AlessandroJGomes/Word-Clock/Word-Clock2/Presentazione/WordClock.pptx

## Word-Clock

Alessandro gomes e Fabio gola

## Indice

- Analisi
- Progettazione
- Implementazione
- Test
- Conclusione

## Slide 3

Analisi

## Analisi – richiesta del mandante

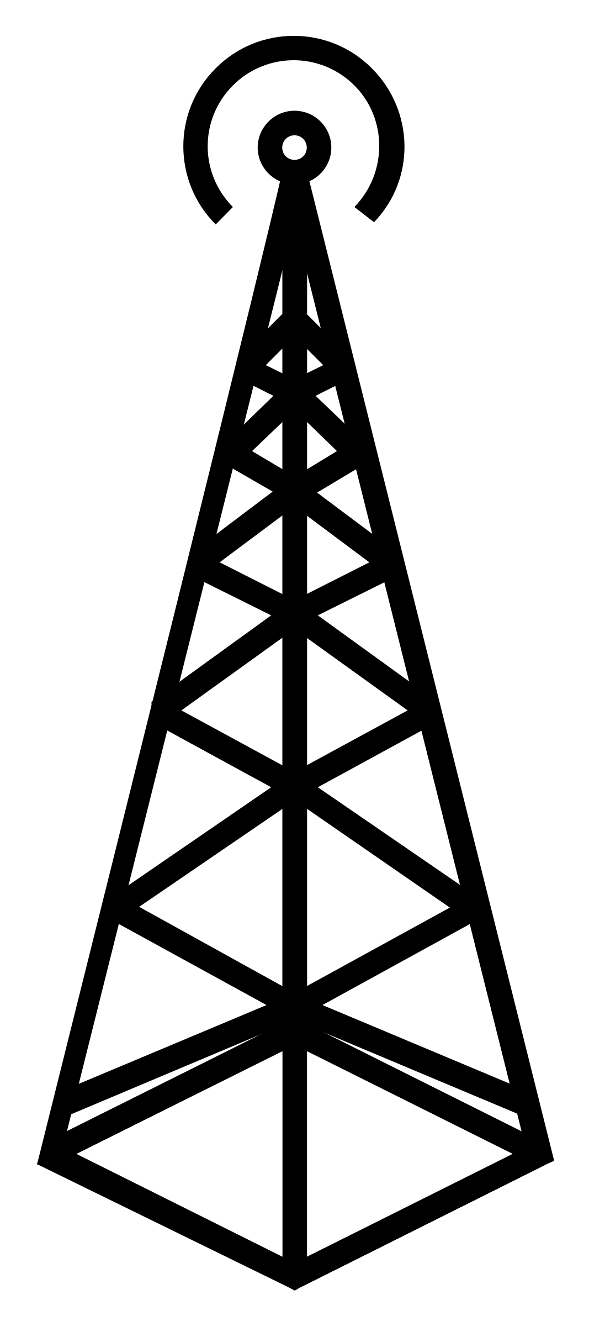
[picture p58: figure]
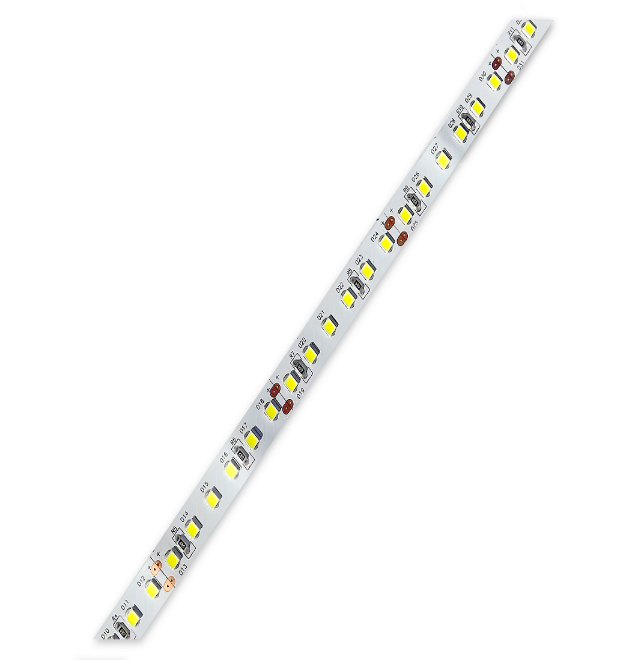
[picture p59: figure]
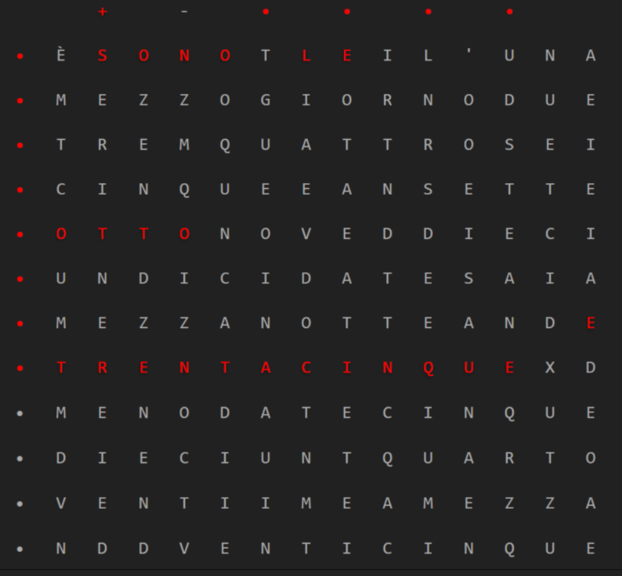
[picture p60: figure]
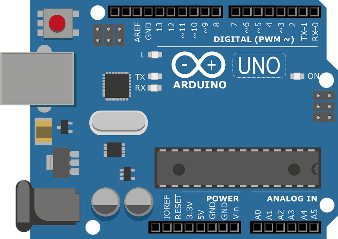
[picture p61: figure]
Risultati immagini per arduino
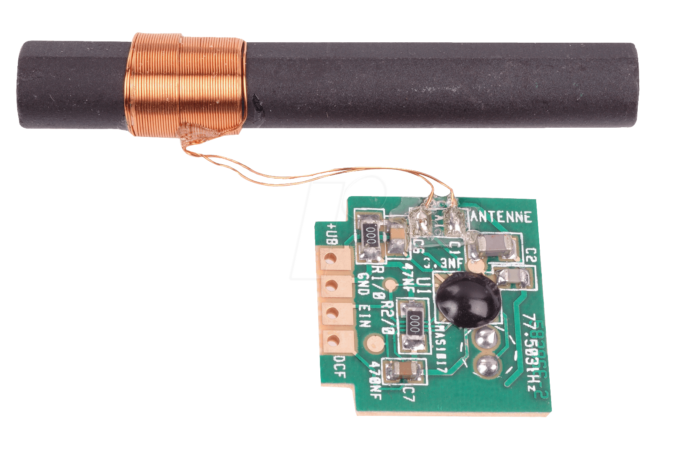
[picture p62: figure]

## Analisi – costi

## Slide 6

Progettazione

## Progettazione

Sincronizzazione orario
Gestione illuminazione
Controllo on board

Arduino

Arduino

Arduino

## Progettazione – controllo on board


## Slide 9

Implementazione

## Implementazione elettrovalvola

## Implementazione infrarossi

## Slide 12

Test

## Test

## Test

## Slide 15

Conclusioni

## Conclusioni

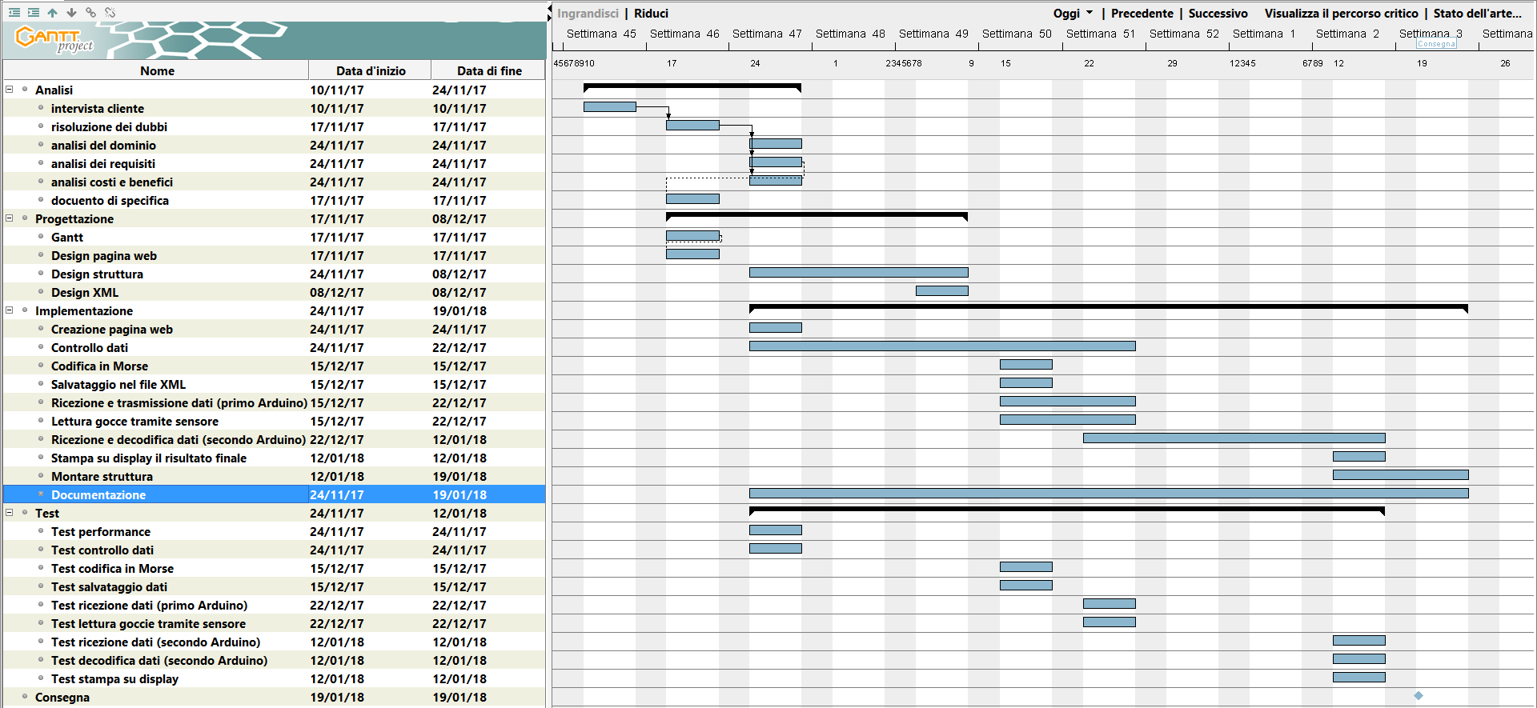
[picture p63: figure]

## Conclusioni

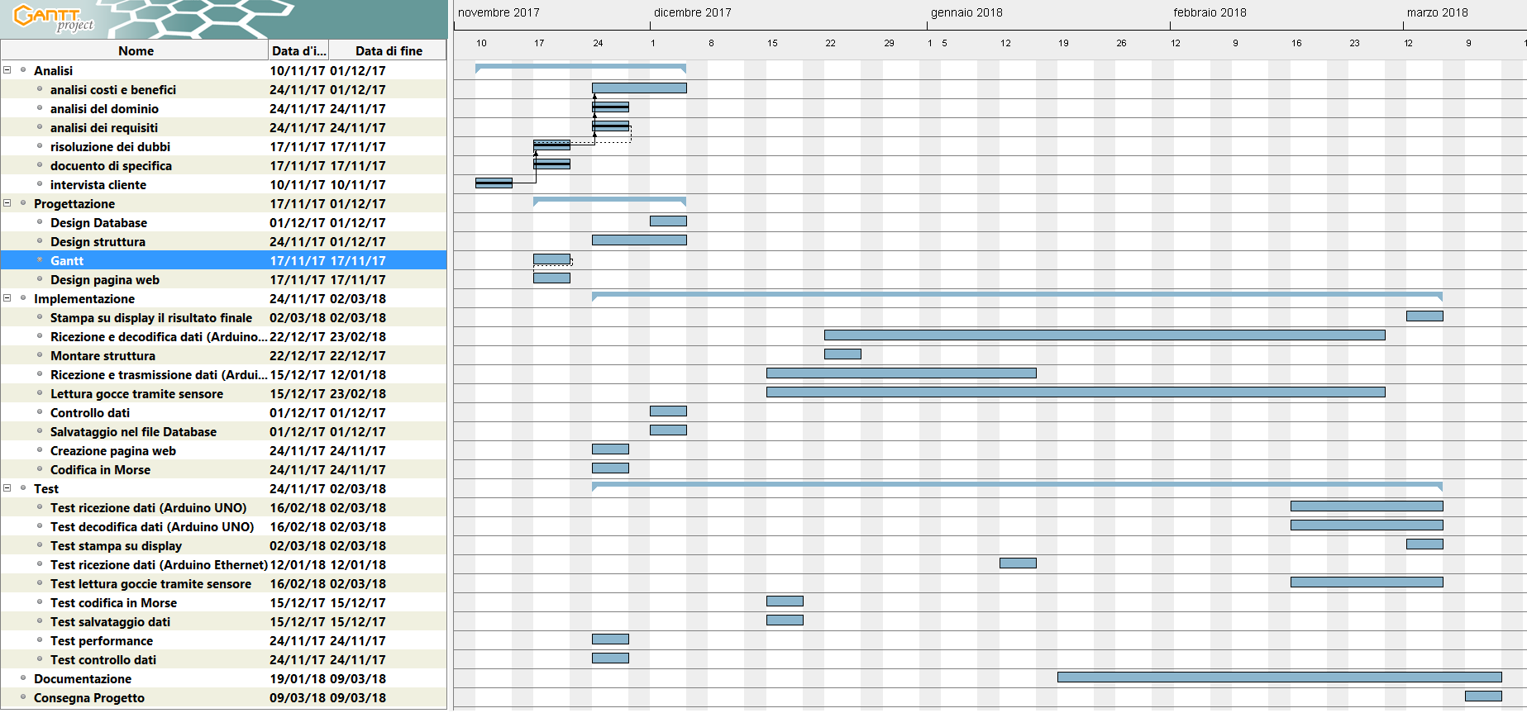
[picture p64: figure]

## Sviluppi futuri

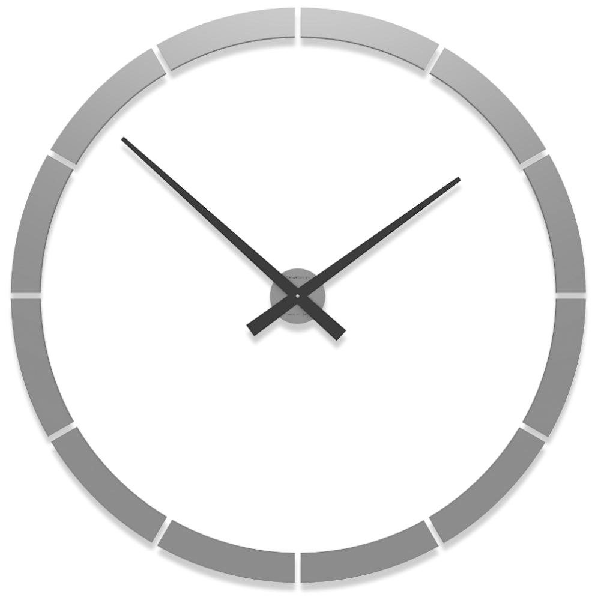
[picture p65: figure]
Risultati immagini per orologio

## Slide 19

Domande ?
