AlessandroJGomes/Word-Clock/Word-Clock2.1/doc/Allegati/20170317_102902.jpg

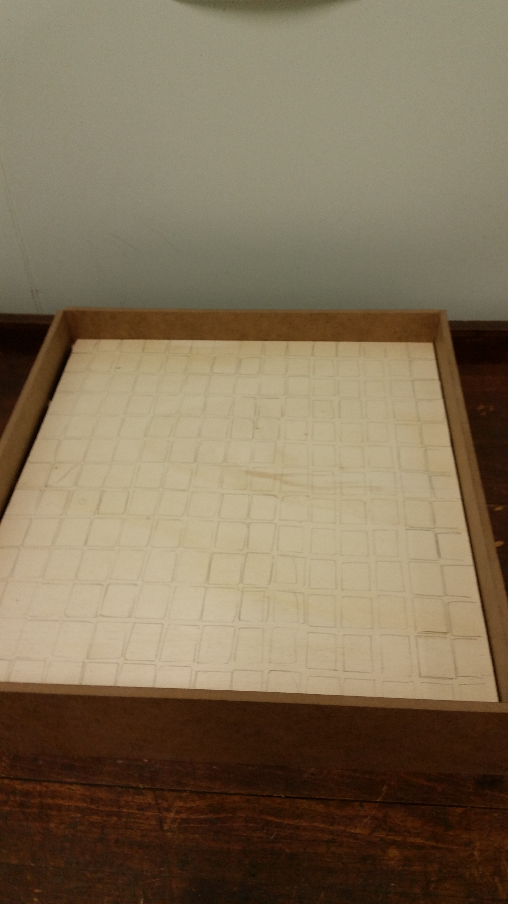
Word-Clock2.1/doc/Allegati/20170317_102902.jpg
