AlessandroJGomes/Word-Clock/Word-Clock2.1/doc/Allegati/20170505_132712.jpg

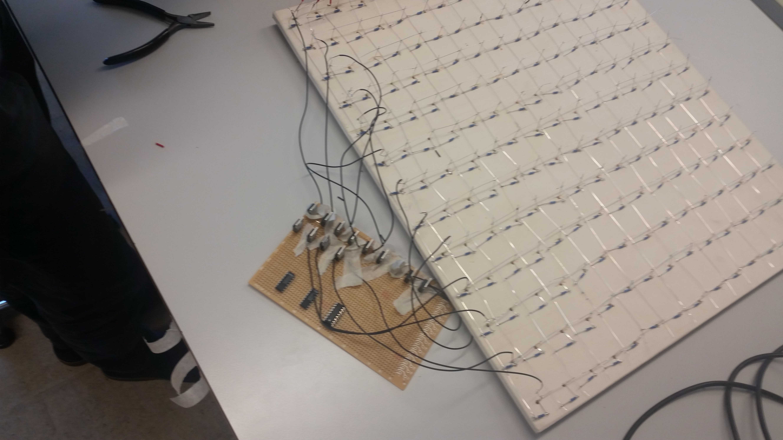
Word-Clock2.1/doc/Allegati/20170505_132712.jpg
