AlessandroJGomes/Word-Clock/Word-Clock2.1/doc/Allegati/De.PNG

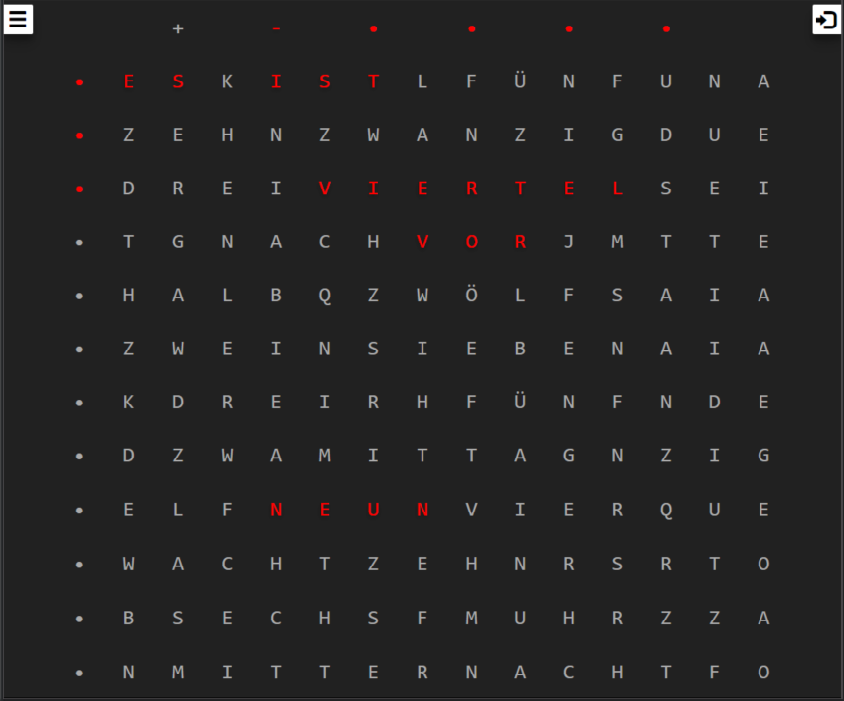
Word-Clock2.1/doc/Allegati/De.PNG
