AlessandroJGomes/Word-Clock/Word-Clock2.1/doc/Allegati/Fr.PNG

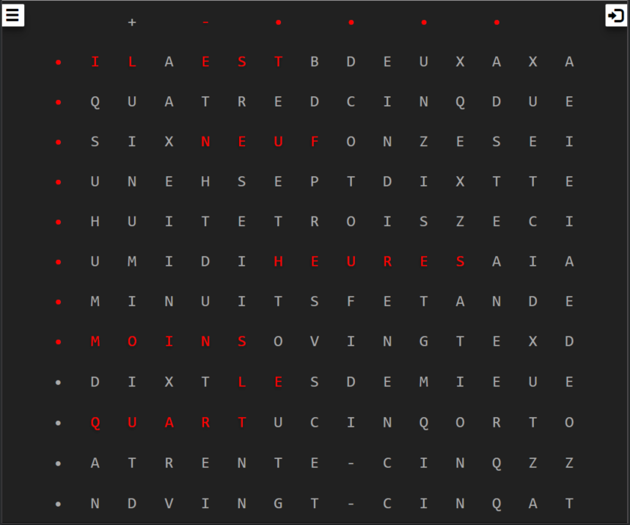
Word-Clock2.1/doc/Allegati/Fr.PNG
