AlessandroJGomes/Word-Clock/Word-Clock2.1/doc/Allegati/Griglia.png

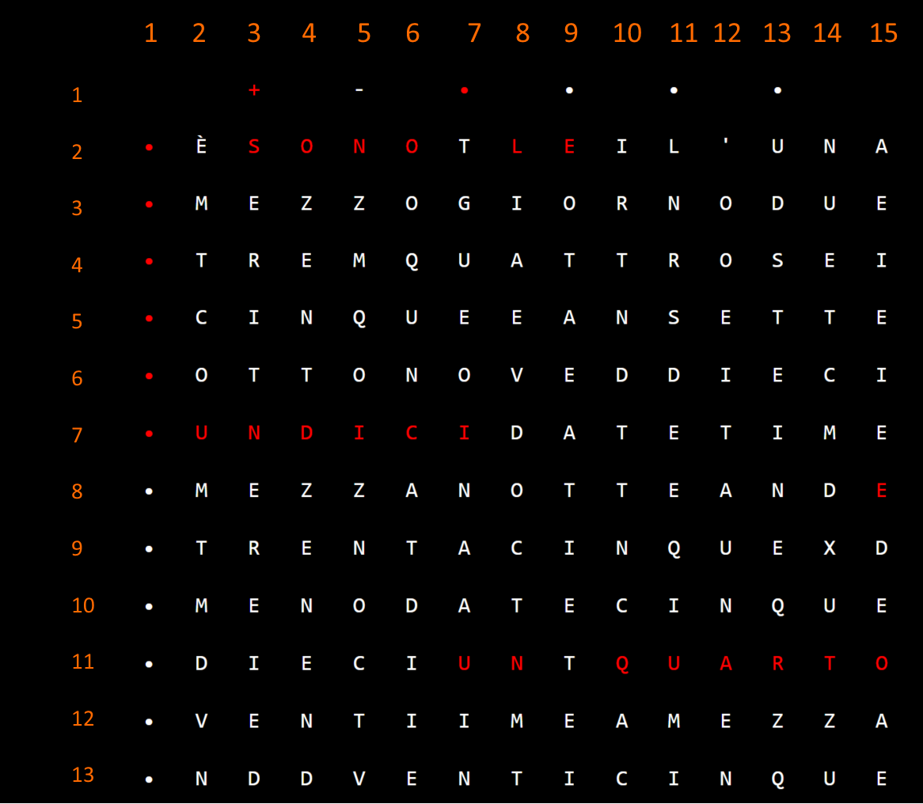
Word-Clock2.1/doc/Allegati/Griglia.png
