AlessandroJGomes/Word-Clock/Word-Clock2.1/doc/Allegati/veroboard.jpg

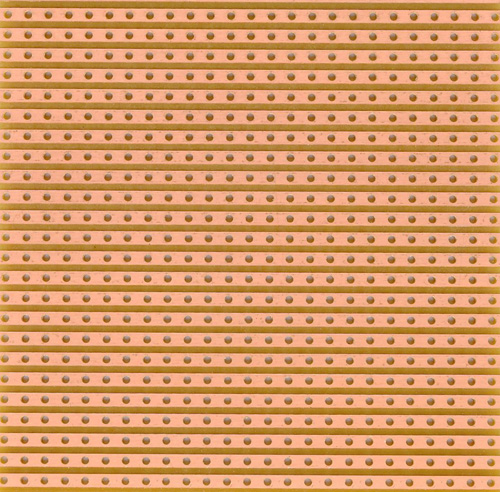
Word-Clock2.1/doc/Allegati/veroboard.jpg
