AlessandroJGomes/Word-Clock/Word-Clock2/Presentazione/accensioneSimboli.PNG

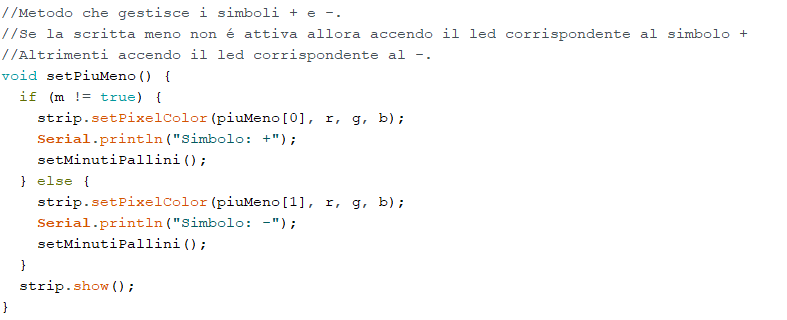
Word-Clock2/Presentazione/accensioneSimboli.PNG
