AlessandroJGomes/Word-Clock/Word-Clock2/Presentazione/arrayParoleSpeciali.PNG

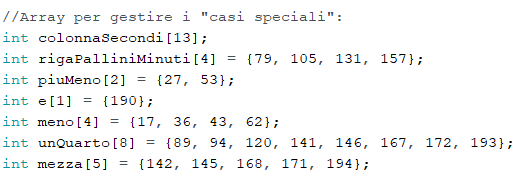
Word-Clock2/Presentazione/arrayParoleSpeciali.PNG
