AlessandroJGomes/Word-Clock/Word-Clock2/Presentazione/costo personale.PNG

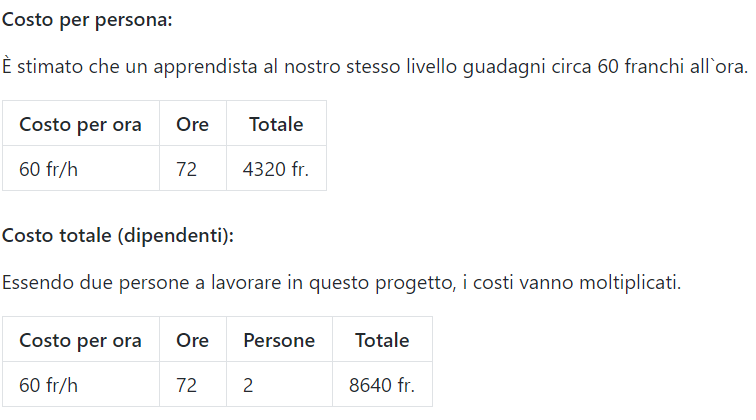
Word-Clock2/Presentazione/costo personale.PNG
