AlessandroJGomes/Word-Clock/Word-Clock2/Presentazione/costomateriale.PNG

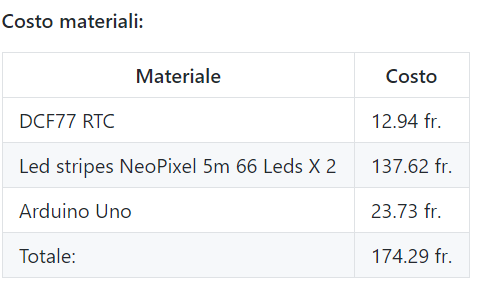
Word-Clock2/Presentazione/costomateriale.PNG
