AlessandroJGomes/Word-Clock/Word-Clock2/Presentazione/costotot.PNG

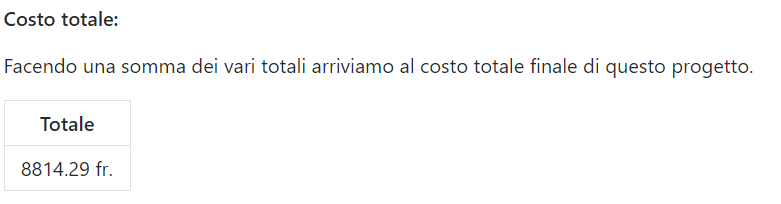
Word-Clock2/Presentazione/costotot.PNG
