AlessandroJGomes/Word-Clock/Word-Clock2/Presentazione/df77prova1.PNG

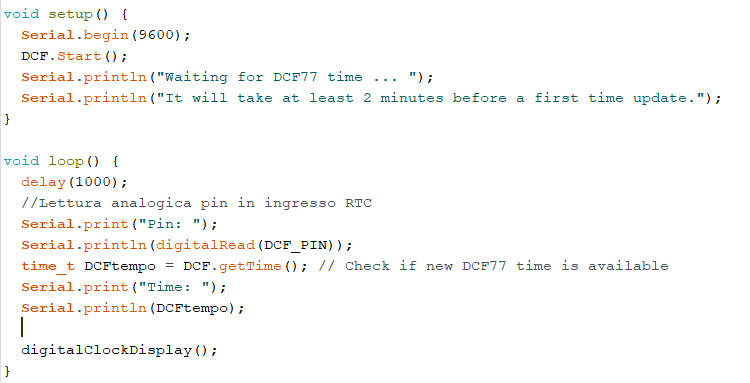
Word-Clock2/Presentazione/df77prova1.PNG
