AlessandroJGomes/Word-Clock/Word-Clock2/Presentazione/GanttConsuntivo.PNG

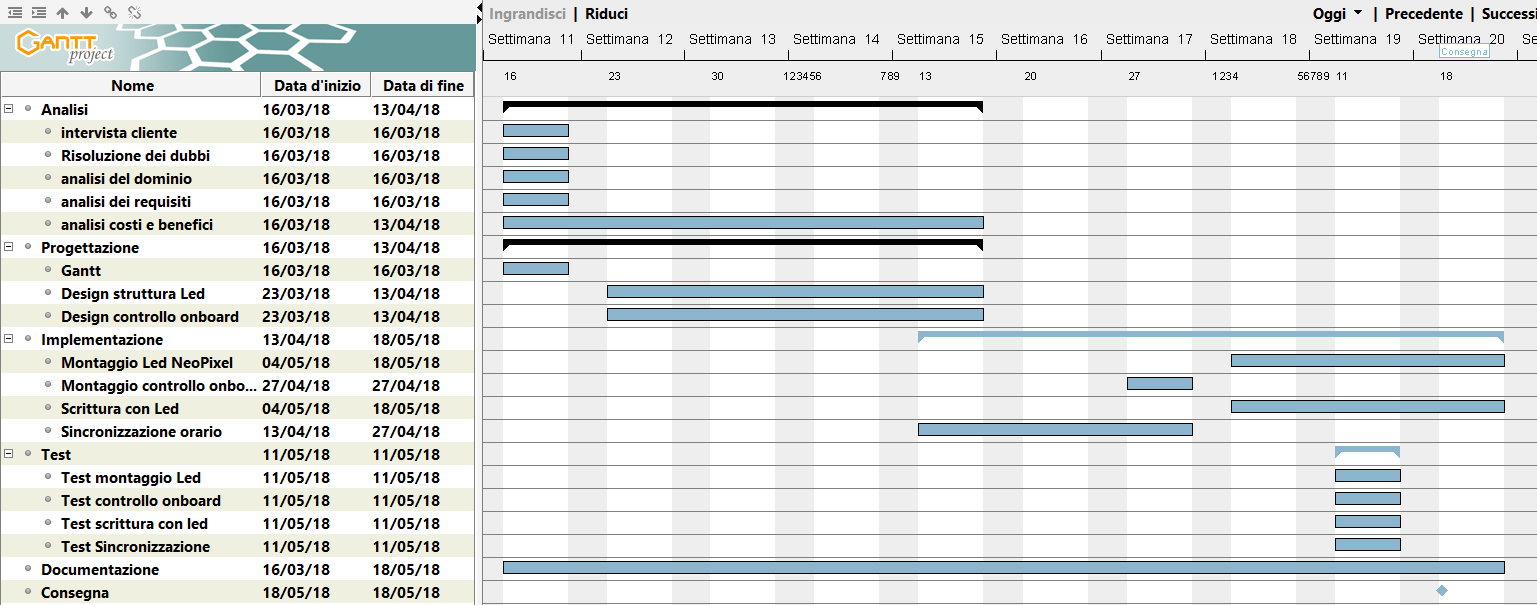
Word-Clock2/Presentazione/GanttConsuntivo.PNG
