AlessandroJGomes/Word-Clock/Word-Clock2/Presentazione/GanttPreventivo.PNG

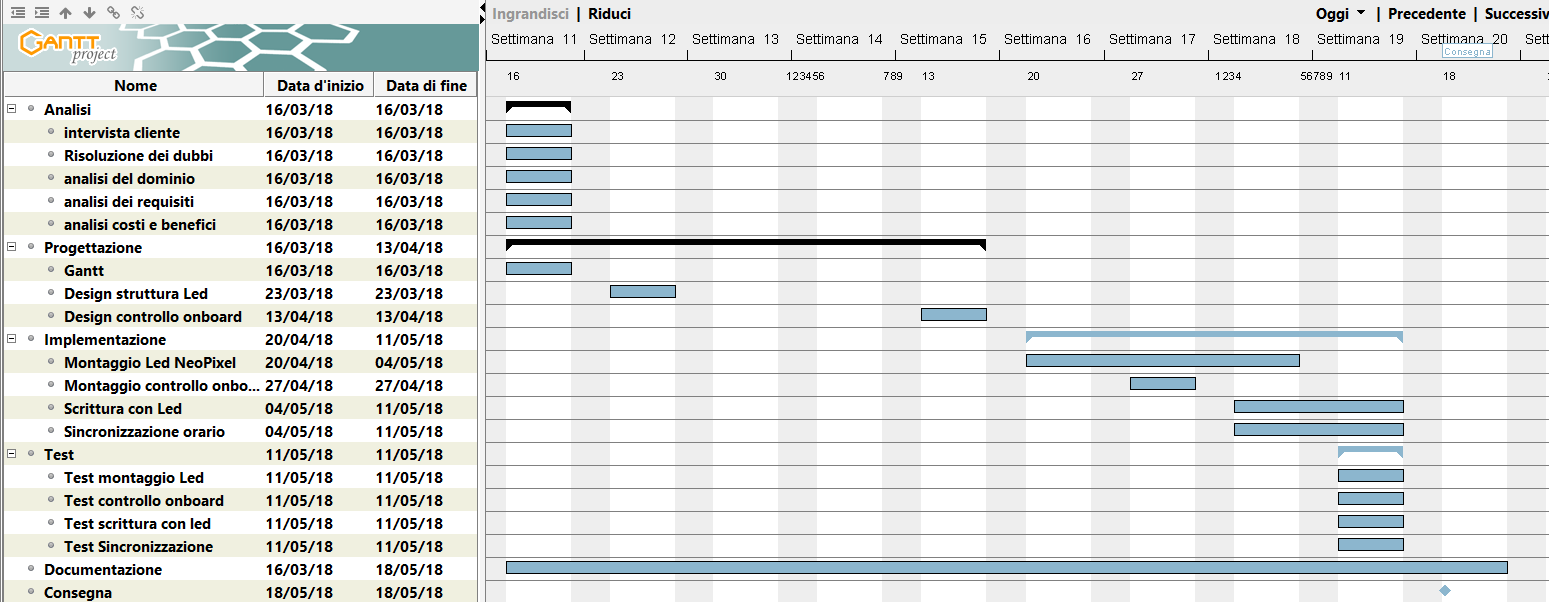
Word-Clock2/Presentazione/GanttPreventivo.PNG
