AlessandroJGomes/Word-Clock/Word-Clock2/Presentazione/gestionePalliniSecondi.PNG

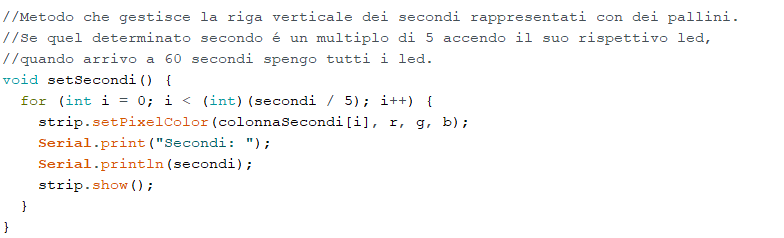
Word-Clock2/Presentazione/gestionePalliniSecondi.PNG
