AlessandroJGomes/Word-Clock/Word-Clock2/Presentazione/LedONOff.PNG

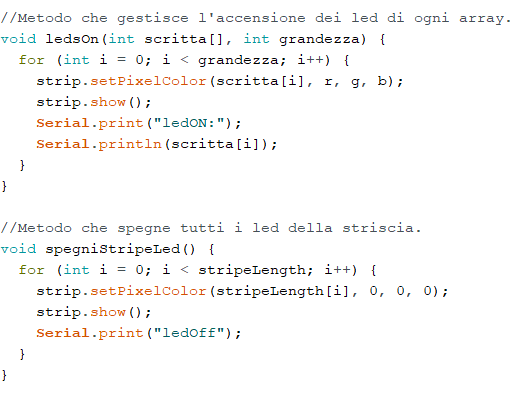
Word-Clock2/Presentazione/LedONOff.PNG
