AlessandroJGomes/Word-Clock/Word-Clock2/Presentazione/loop2.PNG

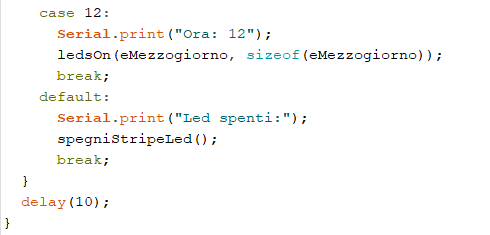
Word-Clock2/Presentazione/loop2.PNG
