AlessandroJGomes/Word-Clock/Word-Clock2/Presentazione/loop.PNG

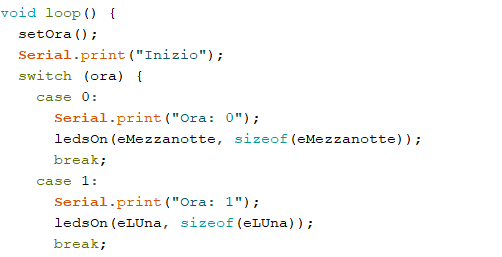
Word-Clock2/Presentazione/loop.PNG
