AlessandroJGomes/Word-Clock/Word-Clock2/Presentazione/provaFunzioneStriscialed.PNG

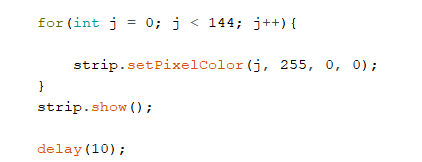
Word-Clock2/Presentazione/provaFunzioneStriscialed.PNG
