AlessandroJGomes/Word-Clock/Word-Clock2/Presentazione/setOra1.PNG

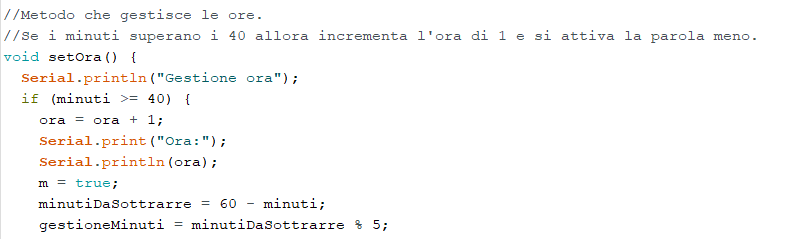
Word-Clock2/Presentazione/setOra1.PNG
