AlessandroJGomes/Word-Clock/Word-Clock2/Presentazione/setOra2.PNG

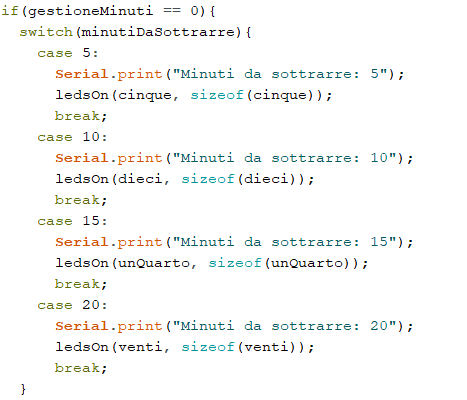
Word-Clock2/Presentazione/setOra2.PNG
