AlessandroJGomes/Word-Clock/(list of files, cad)

Other CAD files:
Word-Clock2.1/doc/Allegati/Modello.skp
