AlessandroJGomes/Word-Clock/Word-Clock2.1/doc/Allegati/RisultatiTest.docx

Test Case | Risultato | Descrizione
TC-001 | Passato
TC-002 | Non passato | Non è stata implementata la parte di sincronizzazione
TC-003 | Non passato | Impossibile eseguire l’azione, non c’è collegamento tra fisico e virtuale
TC-004 | Passato
