AlessandroJGomes/Word-Clock/(list of files, drawings)

Other design files:
Word-Clock2/schemielettrici/SchemaCompleto.fzz
