AlessandroJGomes/Word-Clock/Word-Clock1/Modello fisico/codice/wordclock/wordclock.ino

int ora = 0;
int minuti = 0;
int secondi = 0;
int pausam = 5;


void setup() {
  pinMode(A0, OUTPUT);
  pinMode(A1, OUTPUT);
  pinMode(A2, OUTPUT);
  pinMode(A3, OUTPUT);
  pinMode(5, OUTPUT);
  pinMode(6, OUTPUT);
  pinMode(7, OUTPUT);
  pinMode(8, OUTPUT);
  pinMode(9, OUTPUT);
}

void loop() {
  setOra();
  setMinR();
  setR1();
  setR2();
  setR3();
  setR4();
  setR5();
  setR6();
  setR7();
  setR8();
  setR9();
  setR10();
  setR11();
  setR12();
}
void setOra(){
  if(minuti >= 40){
    ora = ora + 1;  
  }  
}
void pausa(){
  digitalWrite(A0, 0);
  digitalWrite(A1, 0);
  digitalWrite(A2, 0);
  digitalWrite(A3, 0);
  digitalWrite(5, 0);
  digitalWrite(6, 0);
  digitalWrite(7, 0);
  digitalWrite(8, 0);
  digitalWrite(9, 0);
  delayMicroseconds(1);
}
void setMinR(){
  digitalWrite(A3, 0);
  digitalWrite(A0, 1); //abilito row
  int minS = minuti % 5;
  if(minS != 0){
    if(minuti > 40){
      minS = 5 - minS;
      c4();// abilito meno
      //pausa();
      if(minS == 1){
        c6();
      }
      else if(minS == 2){
        
        c6();
        c8();
        
      }
      else if(minS == 3){
        c6();
        c8();
        c10();
        
      }
      else if(minS == 4){
        c6();
        c8();
        c10();
        c12();
      }
      
    }
    else{
      c2();// abilito piu
      
      if(minS == 1){
        c6();
      }
      else if(minS == 2){
        
        c6();
        c8();
        
      }
      else if(minS == 3){
        c6();
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
  digitalWrite(9, 1);
  delay(pausam);
}
void c13(){
  digitalWrite(6, 0);
  digitalWrite(7, 1);
  digitalWrite(8, 1);
  digitalWrite(9, 1);
  delay(pausam);
}
void c14(){
  digitalWrite(6, 1);
  digitalWrite(7, 1);
  digitalWrite(8, 1);
  digitalWrite(9, 1);
  delay(pausam);
}
