AlessandroJGomes/Word-Clock/Word-Clock2/Codice/francoforteclock/francoforteclock.ino

#include <DCF77.h>
#include <TimeLib.h>

#define DCF_PIN 2                // Connection pin to DCF 77 device
#define DCF_INTERRUPT 0          // Interrupt number associated with pin

time_t tempo;
// Non-inverted input on pin DCF_PIN
DCF77 DCF = DCF77(DCF_PIN,DCF_INTERRUPT, true); 

void setup() {
  Serial.begin(9600); 
  DCF.Start();
  Serial.println("Waiting for DCF77 time ... ");
  Serial.println("It will take at least 2 minutes before a first time update.");
}

void loop() {
  delay(1000);
  //Lettura analogica pin in ingresso RTC
  Serial.print("Pin: ");
  Serial.println(digitalRead(DCF_PIN));
  time_t DCFtempo = DCF.getTime(); // Check if new DCF77 time is available
  Serial.print("Time: ");
  Serial.println(DCFtempo);
  
  if (DCFtempo!=0)
  {    
    Serial.println(DCFtempo);
    setTime(DCFtempo);
  }     
  digitalClockDisplay();  
}


void digitalClockDisplay(){
  //digital clock display of the time
  Serial.print(hour());
  printDigits(minute());
  printDigits(second());
  Serial.print(" ");
  Serial.print(day());
  Serial.print(" ");
  Serial.print(month());
  Serial.print(" ");
  Serial.print(year()); 
  Serial.println(); 
}

void printDigits(int digits){
  // utility function for digital clock display: prints preceding colon and leading 0
  Serial.print(":");
  if(digits < 10)
    Serial.print('0');
  Serial.print(digits);
}
