AlessandroJGomes/Word-Clock/(commit log)

2018-03-16 Struttura iniziale
    [Modello.skp, circuit.kicad_pcb, circuit.sch]
2018-03-16 Allegati doc
    [Modello.skp]
2018-03-16 Revert "Allegati doc"
    This reverts commit a7cce2a3067012f973aadfc4a9ea0203092510d9.
    [Modello.skp]
2018-03-16 Revert "Revert "Allegati doc""
    This reverts commit 705f16b0196327cb9946d875ec85440381fe686b.
    [Modello.skp]
2018-04-13 diario + aggiornamento fritzing
    [SchemaCompleto.fzz]
2018-04-20 Diario + codice arduino rtc
2018-05-04 Diario + codici di prova per la gestione dei neopixel
    [SchemaCompleto.fzz]
2018-05-18 Presentazione + aggiornamento doc + aggiornamento codice Led stripe
    [SchemaCompleto.fzz]
