AlessandroJGomes/Word-Clock/Word-Clock2.1/doc/Allegati/20170317_102924.jpg

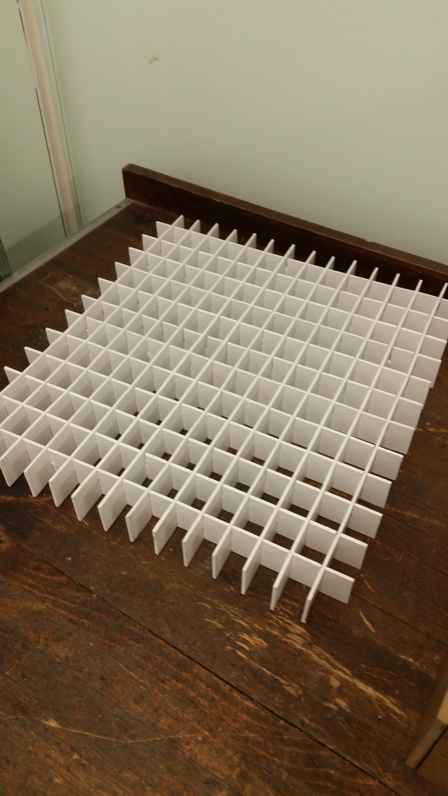
Word-Clock2.1/doc/Allegati/20170317_102924.jpg
